elutsk/RGBmeter/media/proto0.jpg

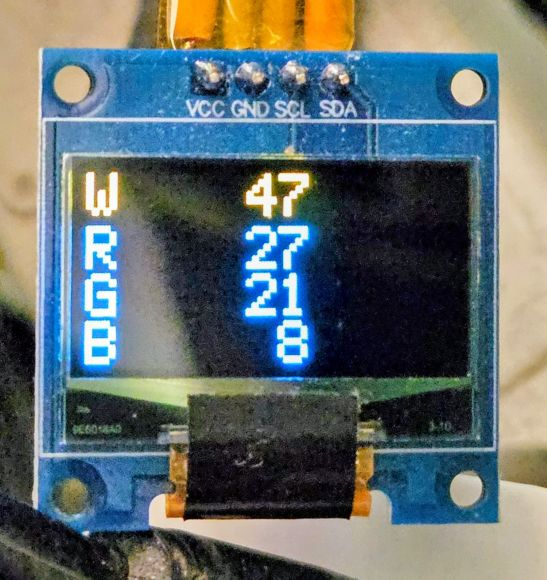
media/proto0.jpg
