elutsk/RGBmeter/media/RGB+memo.jpg

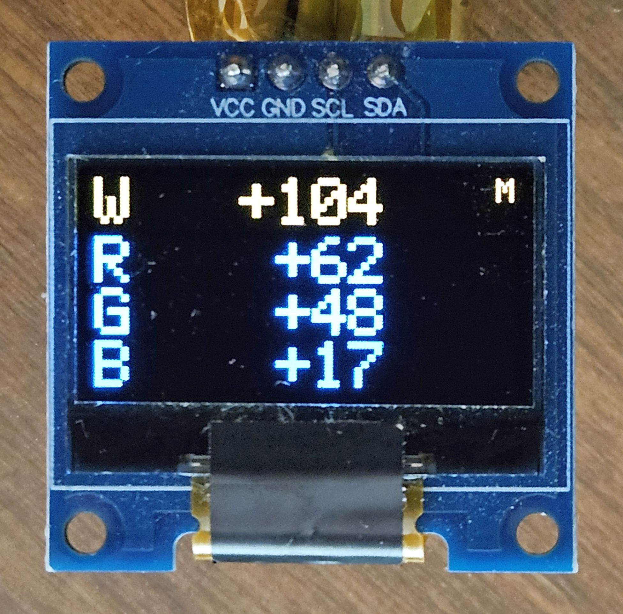
media/RGB+memo.jpg
