elutsk/RGBmeter/media/screen0.jpg

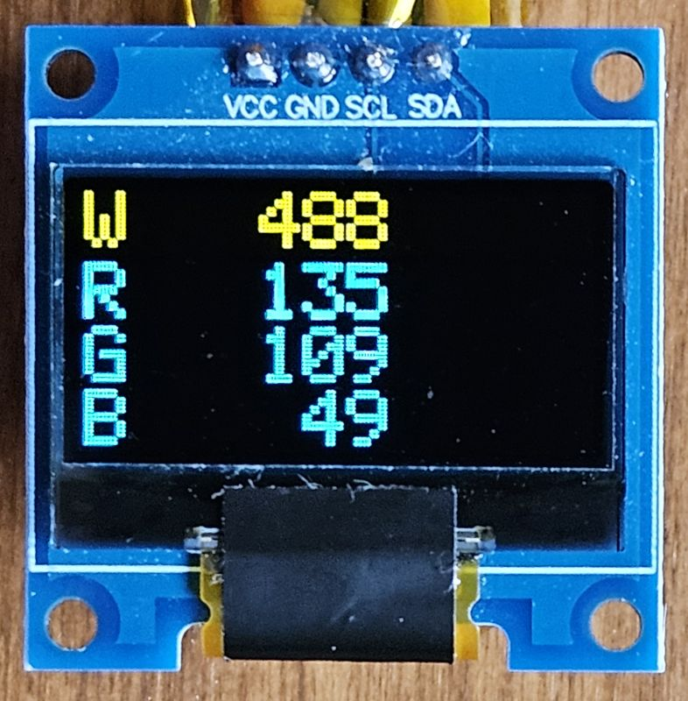
media/screen0.jpg
