elutsk/RGBmeter/media/screen1.jpg

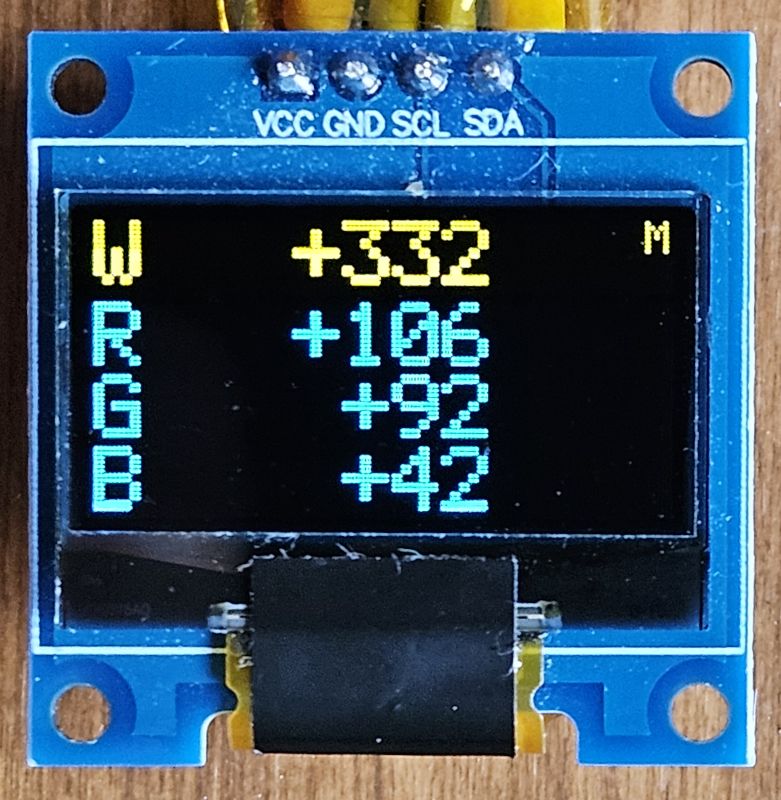
media/screen1.jpg
