elutsk/RGBmeter/media/screen2.jpg

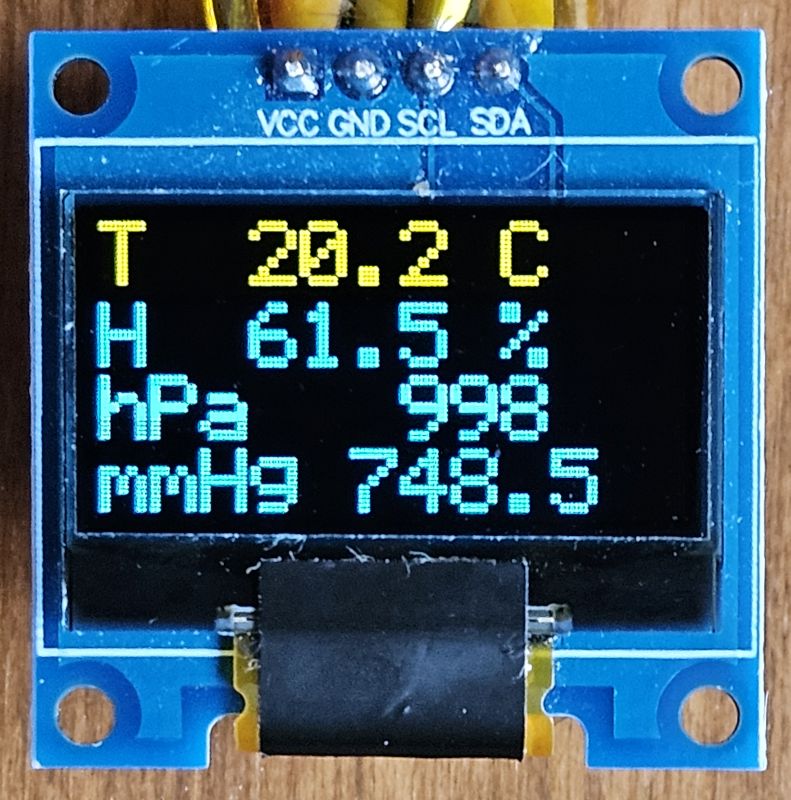
media/screen2.jpg
