elutsk/RGBmeter/media/screen3.jpg

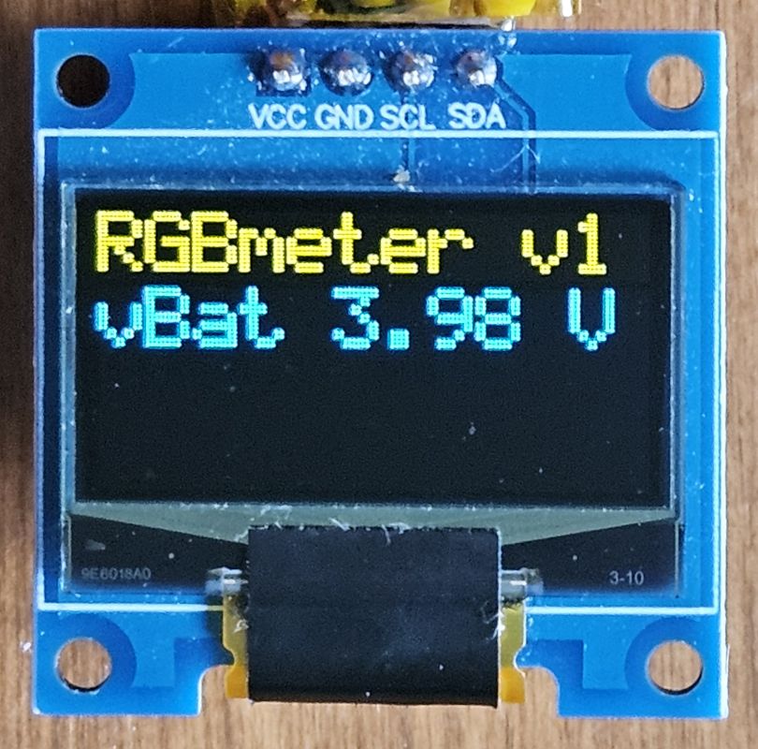
media/screen3.jpg
