elutsk/RGBmeter/media/screens1.jpg

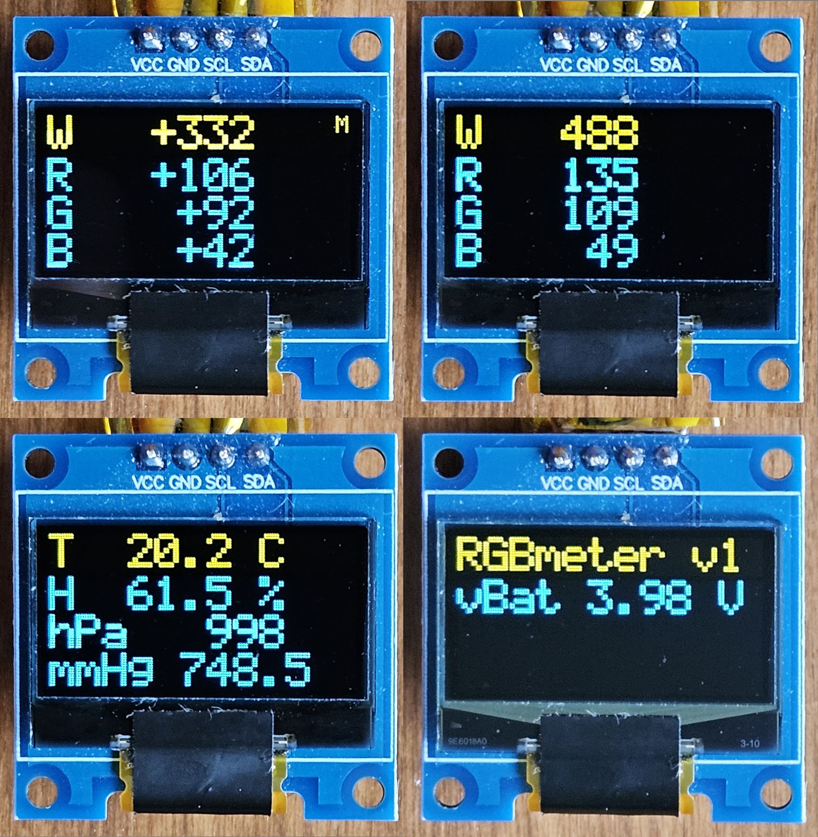
media/screens1.jpg
