elutsk/RGBmeter/media/screens.jpg

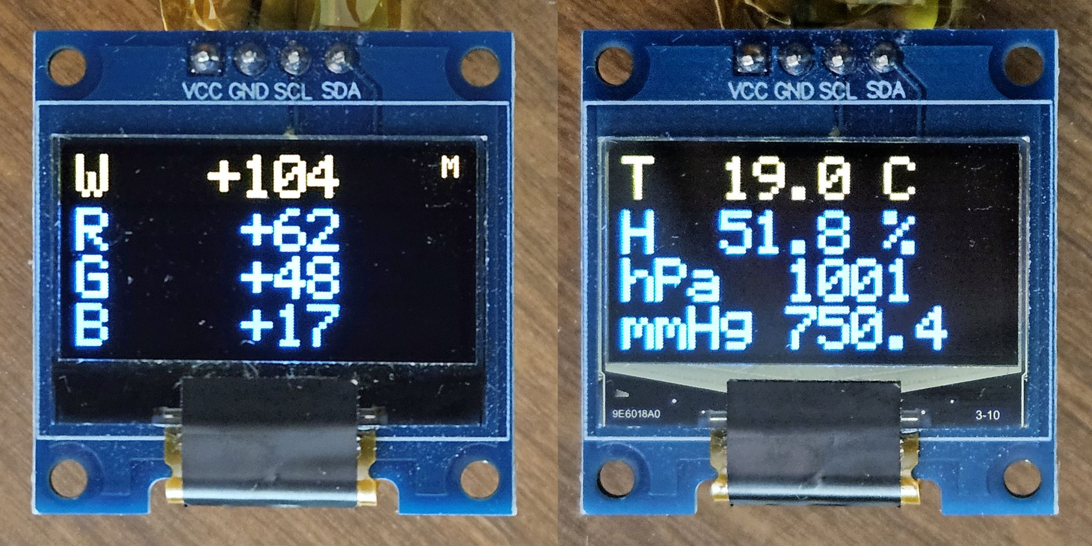
media/screens.jpg
