elutsk/RGBmeter/media/T_H_P.jpg

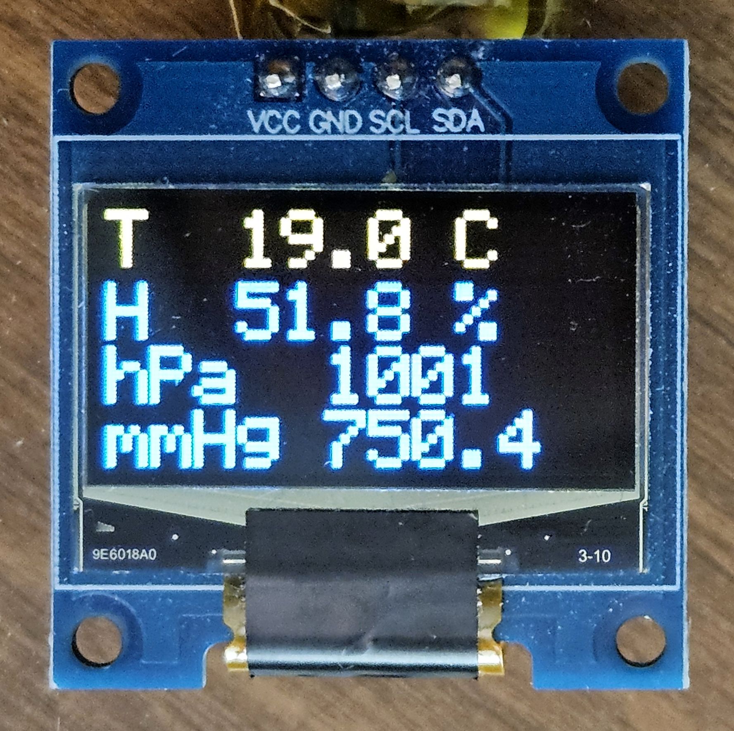
media/T_H_P.jpg
