elutsk/RGBmeter/main/main.cpp

#include "App.h"
#include "Bme688.h"
#include "GpioButton.h"
#include "I2cBus.h"
#include "Ssd1306Display.h"
#include "Veml6040.h"
#include "Ws2812Led.h"
#include "AdcVoltage.h"
#include "DeepSleep.h"
#include "Power.h"
#include "PowerSwitch.h"
#include "esp_err.h"
#include "esp_log.h"
#include "esp_system.h"
#include "freertos/FreeRTOS.h"
#include "freertos/task.h"

static const char* TAG = "rgbmeter";

namespace {

constexpr gpio_num_t kSdaPin = GPIO_NUM_12;
constexpr gpio_num_t kSclPin = GPIO_NUM_13;
constexpr gpio_num_t kModeButtonPin = GPIO_NUM_11;    // button 1
constexpr gpio_num_t kMemoryButtonPin = GPIO_NUM_10;  // button 2
constexpr gpio_num_t kLedPin = GPIO_NUM_48;           // on-board WS2812
constexpr int kTickPeriodMs = 200;                    // longer than the 160 ms VEML6040 integration time
constexpr uint8_t kLedLevel = 64;                  // RGB LED brightness
constexpr gpio_num_t kVbusPin = GPIO_NUM_3;           // VBUS through the on-board 100k/100k divider
constexpr int kVbusDividerRatio = 2;                  // (100k + 100k) / 100k
constexpr bool kBusDiagMode = false;                // i2c + vbus diagnostics mode
constexpr uint32_t kWakeHoldMs = 750;                 // plus about 250 ms of boot: about 1 s, like a long click
constexpr gpio_num_t kPowerOffPin = GPIO_NUM_9;       // CS of the battery protection IC (DW01A) through 4.7k
constexpr uint32_t kCutTimeoutMs = 200;               // the DW01A cuts after 10..20 ms

// Diagnostics: logs every 7-bit address that answers with ACK.
void scanBus(const I2cBus& bus) {
    constexpr uint16_t kFirstAddress = 0x08;
    constexpr uint16_t kLastAddress = 0x77;
    constexpr int kScanTimeoutMs = 50;
    int found = 0;
    for (uint16_t address = kFirstAddress; address <= kLastAddress; ++address) {
        const esp_err_t err = i2c_master_probe(bus.handle(), address, kScanTimeoutMs);
        if (err == ESP_OK) {
            ESP_LOGI(TAG, "scan: 0x%02X ACK", address);
            ++found;
        } else if (err != ESP_ERR_NOT_FOUND) {
            ESP_LOGW(TAG, "scan: 0x%02X %s", address, esp_err_to_name(err));
        }
    }
    ESP_LOGI(TAG, "scan: %d device(s) found", found);
}

// True if powered from USB; false on battery or if VBUS cannot be read.
bool isOnUsb(IVoltageSensor& vbus) {
    int millivolts = 0;
    return vbus.readMillivolts(millivolts) && evaluatePower(millivolts).onUsb;
}

StartCause startCause() {
    if (DeepSleep::wokeByButton()) return StartCause::ButtonWake;
    const esp_reset_reason_t reason = esp_reset_reason();
    if (reason == ESP_RST_POWERON || reason == ESP_RST_BROWNOUT) return StartCause::PowerOn;
    return StartCause::Other;
}

// Switches the device off. On battery the protection IC cuts the power: zero
// current. On USB the battery is not used anyway, so the device goes to deep sleep.
[[noreturn]] void powerDown(PowerSwitch& powerSwitch, IVoltageSensor& vbus) {
    DeepSleep::waitForRelease(kModeButtonPin);  // while held, the button keeps the protection IC on
    if (!isOnUsb(vbus)) powerSwitch.cut(kCutTimeoutMs);  // returns only if the power stayed on
    DeepSleep::enter(kModeButtonPin);
}

}  // namespace

// Composition root: creates the concrete hardware objects,
// wires them into App through interfaces, and runs the main loop.
extern "C" void app_main(void) {
    PowerSwitch powerSwitch(kPowerOffPin);  // first: drives CS low, the battery stays connected

    // The power source decides how this start is treated, so VBUS is read first.
    AdcVoltage vbus(kVbusPin, kVbusDividerRatio);
    const bool vbusReady = vbus.init();

    // Started by button 1: only a long press really switches the device on, an accidental
    // short one switches it off again. Done before anything else uses the button pin.
    if (decideStart(startCause(), isOnUsb(vbus)) == StartAction::ConfirmButton && !DeepSleep::confirmWake(kModeButtonPin, kWakeHoldMs)) powerDown(powerSwitch, vbus);

    Ws2812Led led(kLedPin);
    I2cBus bus(kSdaPin, kSclPin);
    Veml6040 veml(bus);
    Ssd1306Display oled(bus);
    Bme688 bme(bus);
    GpioButton modeButton(kModeButtonPin);
    GpioButton memoryButton(kMemoryButtonPin);

    // Startup failure: report it, show red and stop here. No return: leaving
    // app_main would destroy all objects above, including the LED driver.
    auto fail = [&led](const char* what) {
        ESP_LOGE(TAG, "%s init failed", what);
        led.setColor(kLedLevel, 0, 0);
        while (true) vTaskDelay(portMAX_DELAY);
    };

    if (!led.init()) {
        ESP_LOGE(TAG, "LED init failed");
    } else {
        led.ledTest(kLedLevel, 200);        // quick test sequence
    }

    if (!vbusReady) fail("VBUS ADC");
    if (kBusDiagMode) {
        // VBUS first: the supply voltage is the first suspect when something fails.
        int startupMillivolts = 0;
        if (vbus.readMillivolts(startupMillivolts)) ESP_LOGI(TAG, "startup VBUS %d mV (uncorrected)", startupMillivolts);
        scanBus(bus);  // scan i2c bus for all connected peripherals
    }

    if (!oled.init()) fail("SSD1306");
    if (!veml.init()) fail("VEML6040");
    if (!bme.init()) fail("BME688");

    led.pulse(0, kLedLevel, 0, 1000);  // all devices are up: green for 1 s
    App app(veml, bme, vbus, oled, led, modeButton, memoryButton, kTickPeriodMs);    

    while (true) {
        app.tick();

        const App::SleepReason reason = app.sleepRequest();
        if (reason != App::SleepReason::None) {
            ESP_LOGI(TAG, "sleep requested: %s", App::sleepReasonName(reason));
            led.sleep();
            oled.sleep();
            veml.shutdown();
            powerDown(powerSwitch, vbus);  // never returns: switching on again is a reboot
        }

        vTaskDelay(pdMS_TO_TICKS(kTickPeriodMs));
    }
}
