elutsk/RGBmeter/(commit log)

2026-10-13 Project skeleton: ESP32-S3, C++14, flash/PSRAM defaults
2026-10-13 Add drivers component with I2cBus (RAII bus owner)
2026-10-13 Add core/IColorSensor and VEML6040 driver, log RGBW
2026-10-14 Readme updated. Display prototype UI photo added
2026-10-14 Add BME688 via Bosch BME68x SensorAPI, show climate screen
2026-10-14 Add second button, short and long clicks
    [App.h, GpioButton.cpp, GpioButton.h, IButton.h, main.cpp]
2026-10-14 Add RGB memory: save with button 2, show signed differences
2026-10-15 Nologo ESP32-S3 Super Mini resources added
2026-10-15 Nologo ESP32-S3 Super Mini resources updated
2026-10-15 Add RGB LED support. Testing
2026-10-15 Add RGB LED support. Testing + i2c peripherals presence indication
2026-10-15 Add RGB LED support. Add dimmer
2026-10-17 Add ADC voltage driver, log VBUS
2026-10-17 Add Status screen with VBUS, move OLED warm-up into the display driver
2026-10-18 Add battery state: USB/battery detection, vBat on Status, low battery LED alert, ADC/divider input correction
    [App.h, IRgbLed.h, Power.h, Ws2812Led.cpp, Ws2812Led.h, main.cpp]
2026-10-18 OLED display advanced diagnostics because of unstable init
    [I2cBus.cpp, I2cBus.h, main.cpp]
2026-10-18 more OLED display and i2c bus diagnostics
2026-10-18 OLED display rock stable now. Diag details removed. i2c scan remains
2026-10-18 OLED display and VEML sensor sleep mode design, part 1
2026-10-18 OLED display and VEML sensor sleep mode design, ESP32 sleep mode, buttons on/off add
2026-10-18 GPIO48 RED LED suppression added during deep sleep mode - saving 1mA on battery
2026-10-20 Battery protection + button + low power circuit add (KiCad + JPG)
    [RGBmeter.kicad_pcb, RGBmeter.kicad_sch]
2026-10-20 Battery protection + new button processing + low power circuit support in code add
